Rheinluft/AES256-GCM-Security-System/AES/jetson/bridge/README.md

# Jetson Bridge

Jetson Orin Nano를 Zybo TX와 RX 사이의 투명 L2 중간 노드로 구성하는 파일이다.

## 파일

- `26-08-13_브리지_현재_구성.md`: 네트워크, 패킷 감시, 공격 엔진과 배포 위치
- `scripts/apply_br_video.sh`: 두 유선 NIC를 `br-video`에 연결
- `scripts/rollback_br_video.sh`: `br-video` 연결을 해제하고 유선 NIC를 NetworkManager에 다시 연결

Dashboard와 공격 엔진은 [`../dashboard`](../dashboard/README.md), Zybo TX/RX와
PetaLinux 소스는 [`../../fpga`](../../fpga/README.md)에 있다. RX 상태는 영상
bridge가 아니라 별도의 5-pin UART를 통해 PC로 전달된다.

## 적용

두 유선 NIC만 연결된 Jetson에서는 인터페이스를 자동 탐색한다.

```bash
sudo ./scripts/apply_br_video.sh
```

유선 NIC가 세 개 이상이면 TX 측과 RX 측 인터페이스를 순서대로 지정한다.

```bash
sudo ./scripts/apply_br_video.sh eno1 enx001122334455
```

설정은 NetworkManager connection profile로 저장되며 다음 부팅부터 자동 연결된다. 인터페이스 이름, USB NIC의 MAC 기반 이름과 관리망 주소를 스크립트에 고정하지 않는다.

## 해제

```bash
sudo ./scripts/rollback_br_video.sh
```
