Rheinluft/AES256-GCM-Security-System/DOC/AES_GCM/GCM_Mode.pdf

## Block Cipher Modes of Operation: Galois/Counter

## Mode GCM

## 1 Definitions, Abbreviations, and Symbols

AAD | 추가 인증 데이터(Additional Authenticated Data)
Additional Authenticated Data | 인증 암호화 함수의 입력 데이터로, 인증 대상이지만 암호화하지 않는 데이터
Authenticated Decryption | 암호문을 평문으로 복호화하고 암호문과 AAD의 진위성을 검증하는 GCM 함수
Authenticated Encryption | 평문을 암호문으로 암호화하고 AAD와 암호문에 대한 인증 태그를 생성 하는 GCM 함수
Authentication Tag (Tag) | 우발적 오류와 의도적인 데이터 변경을 검출하도록 설계된 암호학적 검 증값
Block | 사용하는 블록 암호의 블록 크기와 같은 길이의 비트 문자열
Block Cipher | 고정 길이 비트 문자열에 대한 순열의 집합이며, 키에 따라 순열이 결정 됨
Block Size | 주어진 블록 암호와 키에서 입력·출력 비트 문자열의 고정 길이
IV | 초기화 벡터(Initialization Vector)
Nonce | 지정된 문맥에서 한 번만 사용하는 값

## 2 GCM 개요 및 특징

GCM은 연관 데이터가 포함된 인증 암호화(AEAD) 방식으로, 데이터의 기밀성과 진위성·무결

성을 동시에 제공하며 승인된 128비트 블록 암호(일반적으로 AES)와 함께 사용됨.

GCM은 일반 체크섬이나 오류 검출 코드보다 강한 인증 기능을 제공하며, 우발적 변경과 의

도적인 무단 변경을 모두 검출할 수 있음.

GCM은 인증 암호화와 인증 복호화를 제공하며 병렬 처리가 가능해 하드웨어와 소프트웨어

에서 높은 처리량을 구현할 수 있음.

### 2.1 주요 특징

- 기밀 데이터와 추가 인증 데이터의 길이를 미리 알지 못해도 순차적으로 처리할 수 있

음.

- 기반 블록 암호의 암호화 방향 연산만 사용하며 복호화 방향 연산은 필요하지 않음.
- 암호문 복구와 별개로 보호 데이터의 진위성을 검증할 수 있음.
- IV와 데이터 길이를 알고 있으면 일부 블록 암호 연산을 미리 계산할 수 있음.
- 고정된 추가 인증 데이터는 관련 인증 연산을 미리 계산할 수 있음.

### 2.2 사용 시 주의사항

- 같은 키에서는 IV(Nonce)를 재사용하지 않음. 한 번이라도 재사용하면 인증 위조에 취

약해질 수 있음.

- 호환성과 효율성을 위해 96비트 IV 사용을 권장함.
- 인증 태그는 일반적으로 96비트 이상 사용하며, 태그 길이 t는 키와 함께 고정함.

## 3 수학적 구성 요소

### 3.1 비트 문자열 규칙

GCM의 입력과 중간값은 비트 문자열로 처리함. len(X)는 비트 길이, MSBₛ(X)와 LSBₛ(X)는 각

각 왼쪽과 오른쪽 s비트, ||는 연결, ⊕는 XOR을 의미함.

### 3.2 증가 함수

양의 정수 s와 len(X) ≥ s를 만족하는 비트 문자열 X에 대해 s비트 증가 함수 incₛ(X)를 정의

함.

- 카운터 모드에서 사용할 카운터의 하위 s비트를 1씩 증가시키는 함수
- 오른쪽 끝의 s비트(GCM에서는 보통 32비트)만 숫자로 취급해 1을 더하고(mod 2ˢ), 나

머지 상위 비트는 그대로 유지함.

### 3.3 블록 곱셈 연산(Galois 연산)

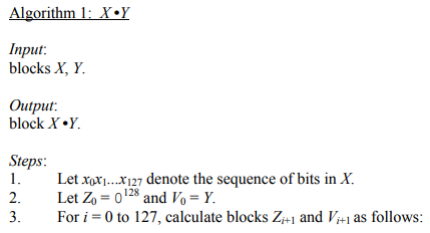
[picture p39: figure]
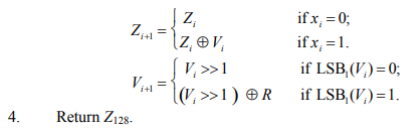
[picture p40: figure]

- 입력: 128비트 블록 X, Y
- 출력: 128비트 곱셈 결과 블록 X · Y

1단계: 초기값 설정 (Step 1~2)

- X를 비트열 x₀, x₁, …, x₁₂₇로 표현함.
- 누적 결과 Z₀를 0¹²⁸로 초기화함.
- 작업 변수 V₀를 Y로 설정함.

2단계: 반복 계산 (Step 3)

i = 0부터 127까지 다음 두 계산을 반복함.

누적 결과 Z 갱신

- xᵢ = 0이면 Zᵢ₊₁ = Zᵢ로 유지함.
- xᵢ = 1이면 Zᵢ₊₁ = Zᵢ ⊕ Vᵢ로 갱신함.

작업 변수 V 갱신

- LSB₁(Vᵢ) = 0이면 Vᵢ₊₁ = Vᵢ >> 1로 설정함.
- LSB₁(Vᵢ) = 1이면 Vᵢ₊₁ = (Vᵢ >> 1) ⊕ R로 설정함.

- R은 11100001 || 0¹²⁰으로 정의되며 유한체 곱셈의 모듈러 축소에 사용함.
- 이 과정은 GF(2¹²⁸)에서 환원 다항식 x¹²⁸ + x⁷ + x² + x + 1을 적용하는 연산

임.

3단계: 최종 결과 반환 (Step 4)

128회 반복 후 Z₁₂₈을 X · Y의 결과로 반환함.

### 3.4 GHASH 함수

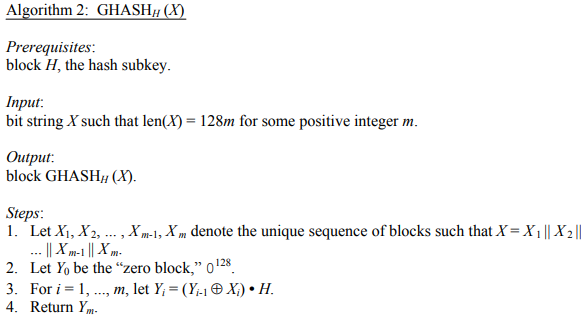
[picture p41: figure]

- 준비물(H): 해시 전용 서브키(Hash Subkey)로, 암호화 키 K로 0¹²⁸ 블록을 암호화해 미

리 생성하는 128비트 값임.

- 입력(X): 인증할 전체 데이터로, GHASH 입력 길이는 128비트의 배수여야 하며 부족한

길이는 4절의 GCM 알고리즘에서 0으로 채움.

- 출력(Yₘ): 전체 데이터를 128비트로 압축한 중간 블록임.

1단계: 128비트씩 쪼개기 (Step 1)

입력 X를 128비트 단위로 분할함.

분할된 블록을 순서대로 X₁, X₂, …, Xₘ으로 정의함.

2단계: 초기값 준비 (Step 2)

연쇄 계산의 초기값 Y₀를 0¹²⁸로 설정함.

3단계: 연쇄 압축 (Step 3)

Yᵢ = (Yᵢ₋₁ ⊕ Xᵢ) · H

GHASH의 핵심 연산으로, 1번 블록부터 m번 블록까지 다음 계산을 반복함.

더하기(⊕): 이전 단계의 결과 Yᵢ₋₁과 현재 데이터 블록 Xᵢ를 XOR함.

곱하기(·H): XOR 결과에 해시 서브키 H를 곱하며, 일반적인 정수 곱셈이 아닌 GF(2¹²⁸)의 유

한체 곱셈을 사용함.

X₁부터 각 블록을 순서대로 XOR하고 H를 곱해 Y₁, Y₂, …, Yₘ을 연쇄적으로 생성함.

4단계: 중간 블록 출력 (Step 4)

마지막 블록 Xₘ까지 연산한 결과 Yₘ을 반환함. 이 값은 최종 인증 태그가 아니라 태그 생성

에 사용되는 중간 블록임.

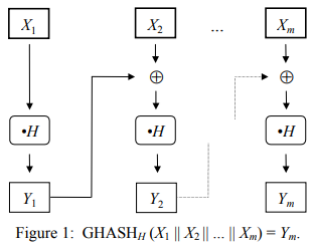
[picture p42: figure]

### 3.5 GCTR 함수(CTR)

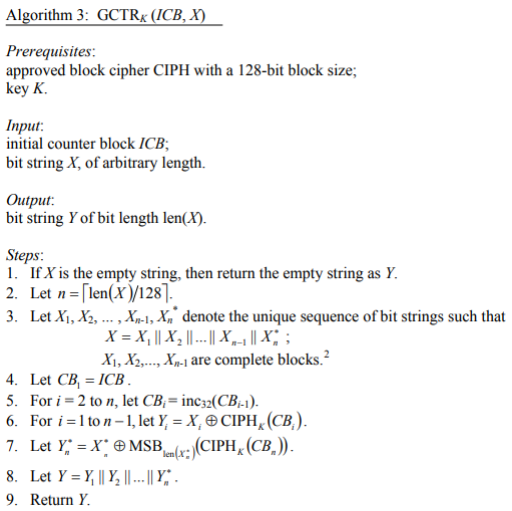
[picture p43: figure]

- 입력(Input): ICB(초기 카운터 블록), X(암호화하거나 복호화할 원본 데이터)
- 출력(Output): Y(처리가 완료된 데이터로, 입력 X와 길이가 같음)

1단계: 데이터 분할 (Step 1~3)

입력 X를 128비트(16바이트) 단위로 분할함.

완전한 블록을 X₁, X₂, …, Xₙ₋₁로 정의함.

입력 길이가 128비트의 배수가 아니면 마지막 부분 블록을 Xₙ*으로 정의하며, 배수이면 마지

막 블록도 완전한 128비트 블록임.

2단계: 카운터 블록 생성 (Step 4~5)

초기 카운터 ICB를 첫 번째 카운터 CB₁으로 사용함.

두 번째 카운터부터 이전 카운터의 오른쪽 32비트만 1씩 증가시키는 inc₃₂ 함수를 사용해

CB₂, CB₃, …, CBₙ을 생성함.

3단계: 완전한 블록 처리 (Step 6)

Yᵢ = Xᵢ ⊕ CIPH_K(CBᵢ)

카운터 CBᵢ를 AES와 같은 블록 암호 CIPH_K로 처리해 128비트 키스트림 블록을 생성함.

키스트림 블록과 128비트 입력 블록 Xᵢ를 XOR하여 출력 블록 Yᵢ를 생성함.

4단계: 부분 블록 처리 (Step 7)

Yₙ* = Xₙ* ⊕ MSB_len(Xₙ*)(CIPH_K(CBₙ))

마지막 부분 블록 Xₙ*이 40비트인 경우, CBₙ의 128비트 키스트림 중 앞의 40비트만 MSB 함

수로 잘라 사용함.

잘라낸 40비트 키스트림과 40비트 입력을 XOR하여 같은 길이의 출력 Yₙ*을 생성함. 따라서

별도의 패딩은 필요하지 않음.

5단계: 최종 연결 (Step 8~9)

처리된 블록을 Y = Y₁ || Y₂ || … || Yₙ* 순서로 연결해 최종 출력 Y를 반환함.

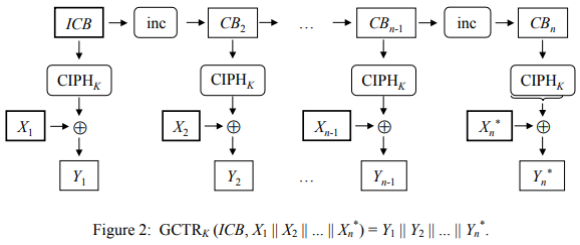
[picture p44: figure]

## 4 GCM 규격

### 4.1 인증 암호화 알고리즘

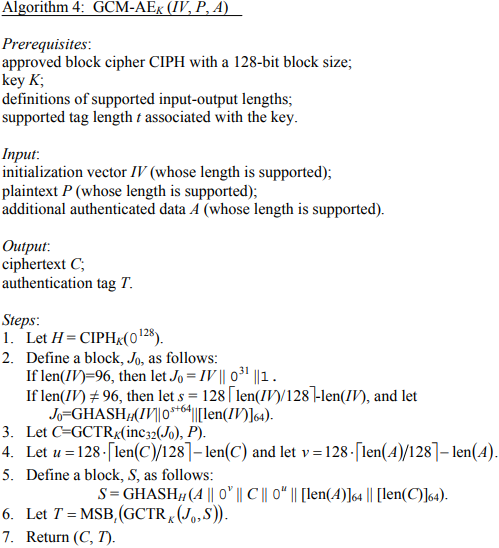
[picture p45: figure]

평문 P와 추가 인증 데이터 A를 입력받아 암호문 C와 인증 태그 T를 생성함.

- 입력: IV(초기화 벡터), P(평문), A(추가 인증 데이터 AAD)
- 출력: C(암호문), T(인증 태그)
- 1단계: 해시 키 생성

0으로 채운 128비트 블록 0¹²⁸을 블록 암호로 암호화해 GHASH에서 사용할 해시 서브

키 H를 생성함.

- 2단계: 초기 카운터 블록 준비

IV를 규격에 맞는 128비트 Pre-counter block J₀로 가공함.

◼ | IV가 96비트이면 J₀ = IV || 0³¹ || 1로 구성함.
◼ | IV가 96비트가 아니면 GHASH를 사용해 128비트 J₀를 생성함.
- 3단계: 평문 암호화

inc₃₂(J₀)를 첫 카운터로 사용해 평문 P를 GCTR로 처리하고 암호문 C를 생성함.

- 4·5단계: 인증 데이터 압축

A, 암호문 C, 패딩 및 두 데이터의 길이를 연결한 뒤 GHASH에 입력해 128비트 블록

S를 생성함.

- 6단계: 인증 태그 생성

S를 J₀와 함께 GCTR에 입력하고, 결과의 앞 t비트(MSBₜ)를 최종 인증 태그 T로 사용함.

- 7단계: 최종 출력

암호문 C와 인증 태그 T를 반환함.

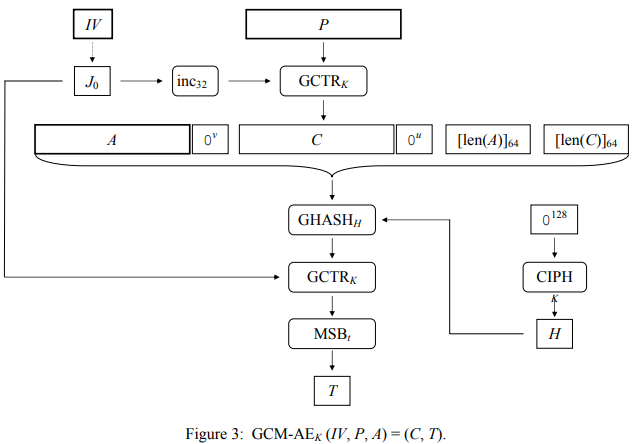
[picture p46: figure]

### 4.2 인증 복호화 알고리즘

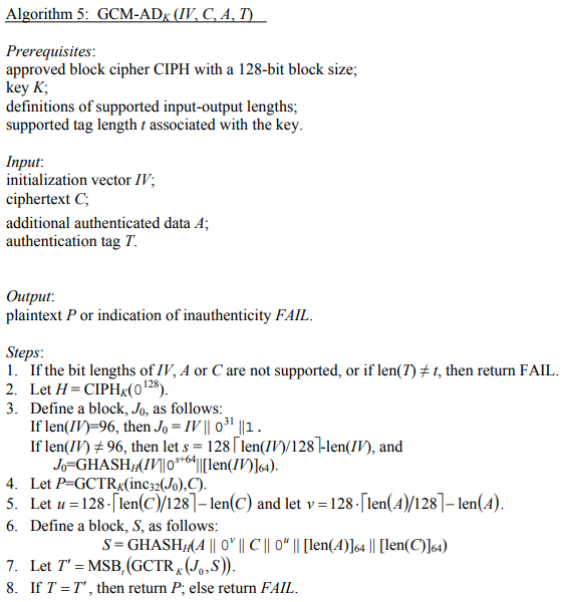
[picture p47: figure]

1단계: 입력 규격 검사

IV, A, C의 길이와 수신 태그 T의 길이를 확인하고, 지원 범위를 벗어나면 즉시 FAIL을 반환

함.

2·3단계: 해시 키와 초기 카운터 준비

암호화 과정과 동일하게 해시 서브키 H를 생성하고 IV로부터 초기 카운터 블록 J₀를 재구성

함.

4단계: 평문 복구

inc₃₂(J₀)를 첫 카운터로 사용해 암호문 C를 GCTR로 처리하고 평문 후보 P를 복구함. 태그 검

증 전에는 이 평문을 사용하지 않음.

5·6단계: 수신 데이터 압축

수신한 A와 C, 패딩 및 길이 정보를 GHASH에 입력해 128비트 블록 S를 생성함.

7단계: 검증용 태그 생성

GCTR_K(J₀, S)를 계산하고 결과의 왼쪽 t비트(MSBₜ)를 잘라 검증용 인증 태그 T′를 생성함.

8단계: 태그 비교 및 최종 결정

- 수신 태그 T와 새로 계산한 태그 T′를 일정 시간 비교 방식으로 검증함.
- 두 태그가 일치하면 복구한 평문 P를 반환함.
- 두 태그가 다르면 평문을 폐기하고 FAIL만 반환함.

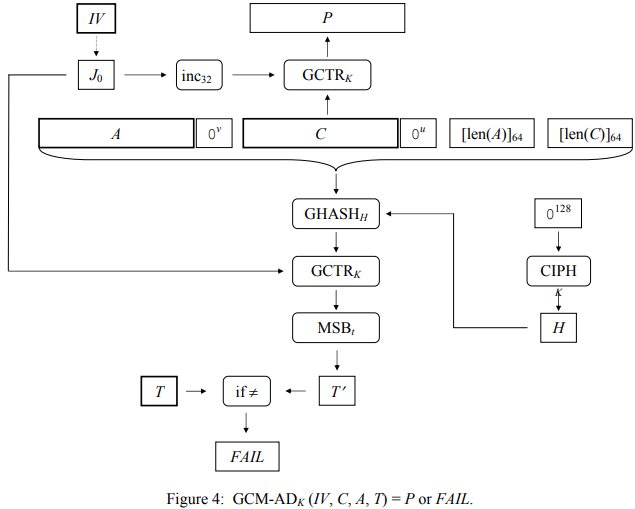
[picture p48: figure]
