Rheinluft/AES256-GCM-Security-System/DOC/AES_GCM/GCM_Summary.pdf

# Block Cipher Modes of Operation:

# Galois/Counter Mode (GCM)

## 1 CTR/GCTR 동작 원리

Counter Block N → | [ AES-256 암호화 ] | → | Keystream N (128bit)
| | | ⊕
| | | Plaintext N (128bit)
| | | ↓
| | | Ciphertext N (128bit)
- 암호화와 복호화에서 동일한 AES 암호화 엔진을 사용함.

### Ci = Pi ⨁ AESK(Counteri

)

### Pi = Ci ⨁ AESK(Counteri)

## 2 IV, J₀ 및 카운터 블록

[Nonce / IV ]

(96 bits)

[Counter ]

(32 bits)

※ 카운터 구성은 권장 길이인 96비트 IV를 기준으로 설명함.

⚫ | Nonce/IV: 96비트 값을 사용, 같은 키에서는 동일한 값을 재사용 금지
⚫ | Counter: J0의 하위 32비트를 1씩 증가시킨 값

### inc32(X) = MSB96

### (X) ∥ [(int(Counter) + 1) mod 2

| 32]32

### J0 = IV ∥ 0

### 31 ∥ 1 = IV ∥ 0x00000001 CB1 = inc32(J0

### ) = IV ∥ 0x00000002 CB2 = inc32(CB1

### ) = IV ∥ 0x00000003 CBN = inc32(CBN−1

### ) = IV ∥ [(N + 1) mod 2

| 32]32

J0: Pre-counter block, 인증 태그 마스킹에 사용함.

CB1: ICB(Initial Counter Block), 첫 번째 평문 블록의 GCTR 처리에 사용함.

## 3 GHASH 구성

### 3.1 Hash Subkey (H)

H = AESₖ(0¹²⁸)

### 3.2 GHASH 입력 데이터 구성

GHASH Input Data

AAD Blocks

(Pad128)

+

Ciphertext Blocks

(Pad128)

+

Lengths Block

len(AAD)64 || len(C)64

↓

Hash Key (H)

### S = GHASHH(A, C) = GHASHH(A ∥ 0

v
∥ C ∥ 0

u

### ∥ [len(A)]64 ∥ [len(C)]64)

A: Additional Authenticated Data(AAD)

0

v
: 0 Padding to align AAD to 128-bit block

C: Ciphertext
0

u
: 0 Padding to align Ciphertext to 128-bit block

[len(A)]64: AAD bit length 64-bit

[len(C)]64: Ciphertext bit length 64-bit

### 3.3 GHASH 연쇄 계산

### init: Y0 = 0

128

### Yi = (Yi−1⨁ Xi) ∙ H (mod g(x)) (for i = 1, 2, … , m) L = [len(A)]64 ∥ [len(C)]64 S = Ym+1 = (Ym⨁ L) ∙ H (mod g(x))

Yi−1: 이전 단계의 누적 결과
Xi
: 현재 128비트 입력 블록
- : GF(2¹²⁸)의 유한체 곱셈

g(x): GCM 환원 다항식(g(x) = x¹²⁸ + x⁷ + x² + x + 1)

곱셈 결과를 GF(2¹²⁸) 범위로 환원할 때 사용하는 상수

R = 128'hE1000000000000000000000000000000

### 3.4 GHASH 인증 특성

- GHASH는 각 단계마다 H를 곱해 이전 결과와 현재 블록을 연결함.

따라서 다음 항목이 모두 인증값에 영향을 줌.

◼ | 블록 내용
◼ | 블록 위치
◼ | 블록 순서
◼ | 데이터 길이

## 4 인증 태그 생성

Auth Tag:

### T = AESK(J0

### ) ⊕ GHASHH(A, C) = AESK(J0

) ⊕ S

Nonce/IV | → | J₀ | → | [AES-256] | → | AESₖ(J₀)
| | | | | | ↓
XOR | → TAG
| | | | | | ↑
AAD | + | Ciphertext | + | Length | → | [GHASH]

## 5 수신 측 태그 검증

입력: [Nonce/IV] [AAD] [Ciphertext] [Received Tag]

→ 송신 측과 동일한 GHASH 및 태그 생성 연산을 수행함.

→ Expected Tag와 Received Tag를 비교함.

Expected Tag = Received Tag: PASS, 평문 반환

Expected Tag ≠ Received Tag: FAIL, 평문 미반환

**AEAD(AES-GCM) 복호화 시 무결성 검증에 실패한 암호문의 평문을 외부에 반환

하지 않고 오류 상태(FAIL)만 반환해야 함.

## 6 GF 연산 비교 및 구현 예시

AES MixColumns
GF(2

8
)

GHASH
GF(2

128)

Shift | Left (<<1) | Right(>>1)
Overflow Check | MSB(bit[7]) | LSB(bit[0])
R | 0x1B | 0xE1000000000000000000000000000000

### 6.1 AES MixColumns

xtime(a) = a[7] ? ((a << 1) ^ 8'h1B) : (a << 1);

### 6.2 GHASH

wire [127:0] V;

wire [127:0] V_next;

wire [127:0] R = 128'hE1000000000000000000000000000000;

assign V_next = (V >> 1) ^ (V[0] ? R : 128'h0);
