Rheinluft/AES256-GCM-Security-System/AES/fpga/stm32/baremetal_uart_echo/device_driver.h

#include "stm32f4xx.h"
#include "option.h"
#include "macro.h"
#include "malloc.h"

// Uart.c

extern void Uart2_Init(int baud);
extern void Uart2_Send_Byte(char data);

extern void Uart1_Init(int baud);
extern void Uart1_Send_Byte(char data);
extern void Uart1_Send_String(char *pt);
extern char Uart1_Get_Char(void);
extern char Uart1_Get_Pressed(void);

// SysTick.c

extern void SysTick_Run(void);

// Led.c

extern void LED_Init(void);
extern void LED_On(void);
extern void LED_Off(void);

// Clock.c

extern void Clock_Init(void);

// Key.c

extern void Key_Poll_Init(void);
extern int Key_Get_Pressed(void);
extern void Key_Wait_Key_Released(void);
extern void Key_Wait_Key_Pressed(void);
