Rheinluft/AES256-GCM-Security-System/AES/fpga/stm32/baremetal_uart_echo/option.h

#define SYSCLK  96000000
#define HCLK	SYSCLK
#define PCLK2	HCLK
#define PCLK1	HCLK/2

#define RAM_START	0x20000000
#define RAM_END		0x20020000
#define HEAP_BASE	(((unsigned int)&__ZI_LIMIT__ + 0x7) & ~0x7)
#define HEAP_SIZE	(4*1024)
#define HEAP_LIMIT	(HEAP_BASE + HEAP_SIZE)
#define STACK_LIMIT	(HEAP_LIMIT + 8)
#define STACK_BASE	(RAM_END + 1)
#define STACK_SIZE	(STACK_BASE - STACK_LIMIT)
