Rheinluft/AES256-GCM-Security-System/AES/fpga/stm32/baremetal_uart_echo/uart.c

#include "device_driver.h"
#include <stdio.h>
#include <stdarg.h>
#include <string.h>
#include <stdlib.h>
#include <ctype.h>

void Uart2_Init(int baud)
{
  double div;
  unsigned int mant;
  unsigned int frac;

  Macro_Set_Bit(RCC->AHB1ENR, 0);                   // PA2,3
  Macro_Set_Bit(RCC->APB1ENR, 17);                   // USART2 ON
  Macro_Write_Block(GPIOA->MODER, 0xf, 0xa, 4);     // PA2,3 => ALT
  Macro_Write_Block(GPIOA->AFR[0], 0xff, 0x77, 8);  // PA2,3 => AF07
  Macro_Write_Block(GPIOA->PUPDR, 0xf, 0x5, 4);     // PA2,3 => Pull-Up  

  volatile unsigned int t = GPIOA->LCKR & 0x7FFF;
  GPIOA->LCKR = (0x1<<16)|t|(0x3<<2);                // Lock PA2, 3 Configuration
  GPIOA->LCKR = (0x0<<16)|t|(0x3<<2);
  GPIOA->LCKR = (0x1<<16)|t|(0x3<<2);
  t = GPIOA->LCKR;

  div = PCLK1/(16. * baud);
  mant = (int)div;
  frac = (int)((div - mant) * 16. + 0.5);
  mant += frac >> 4;
  frac &= 0xf;

  USART2->BRR = (mant<<4)|(frac<<0);
  USART2->CR1 = (1<<13)|(0<<12)|(0<<10)|(1<<3)|(1<<2);
  USART2->CR2 = 0<<12;
  USART2->CR3 = 0;
}

void Uart2_Send_Byte(char data)
{
  if(data == '\n')
  {
    while(!Macro_Check_Bit_Set(USART2->SR, 7));
    USART2->DR = 0x0d;
  }

  while(!Macro_Check_Bit_Set(USART2->SR, 7));
  USART2->DR = data;
}

void Uart1_Init(int baud)
{
  double div;
  unsigned int mant;
  unsigned int frac;

  Macro_Set_Bit(RCC->AHB1ENR, 0);                   // PA9,10
  Macro_Set_Bit(RCC->APB2ENR, 4);                   // USART1 ON
  Macro_Write_Block(GPIOA->MODER, 0xf, 0xa, 18);    // PA9,10 => ALT
  Macro_Write_Block(GPIOA->AFR[1], 0xff, 0x77, 4);  // PA9,10 => AF07
  Macro_Write_Block(GPIOA->PUPDR, 0xf, 0x5, 18);    // PA9,10 => Pull-Up

  div = PCLK2 / (16. * baud);
  mant = (int)div;
  frac = (int)((div - mant) * 16 + 0.5);
  mant += frac >> 4;
  frac &= 0xf;
  USART1->BRR = (mant<<4)|(frac<<0);

  USART1->CR1 = (1<<13)|(0<<12)|(0<<10)|(1<<3)|(1<<2);
  USART1->CR2 = 0 << 12;
  USART1->CR3 = 0;
}

void Uart1_Send_Byte(char data)
{
  if(data == '\n')
  {
    while(!Macro_Check_Bit_Set(USART1->SR, 7));
    USART1->DR = 0x0d;
  }

  while(!Macro_Check_Bit_Set(USART1->SR, 7));
  USART1->DR = data;
}

void Uart1_Send_String(char *pt)
{
  while(*pt != 0)
  {
    Uart1_Send_Byte(*pt++);
  }
}
