Rheinluft/AES256-GCM-Security-System/AES/verification/rx_uvm/tb/uvm/rx_uvm_pkg.sv

`timescale 1ns/1ps

package rx_uvm_pkg;
  import uvm_pkg::*;
  `include "uvm_macros.svh"

  `include "rx_types.sv"
  `include "rx_record_item.sv"
  `include "rx_driver.sv"
  `include "rx_in_monitor.sv"
  `include "rx_out_monitor.sv"
  `include "rx_scoreboard.sv"
  `include "rx_env.sv"
  `include "rx_seq_lib.sv"
  `include "rx_test_lib.sv"

endpackage
