Rheinluft/AES256-GCM-Security-System/(commit log)

2026-08-24 Add integrated AES-256-GCM secure video project
    [pcam.cfg, wireless.cfg]
2026-08-26 assets: tighten project banner spacing
